rasteri/HIDman/hardware/ps2/ps2usb.kicad_pcb

## KiCad design hardware/ps2/ps2usb.kicad_pcb (2024-11-02)

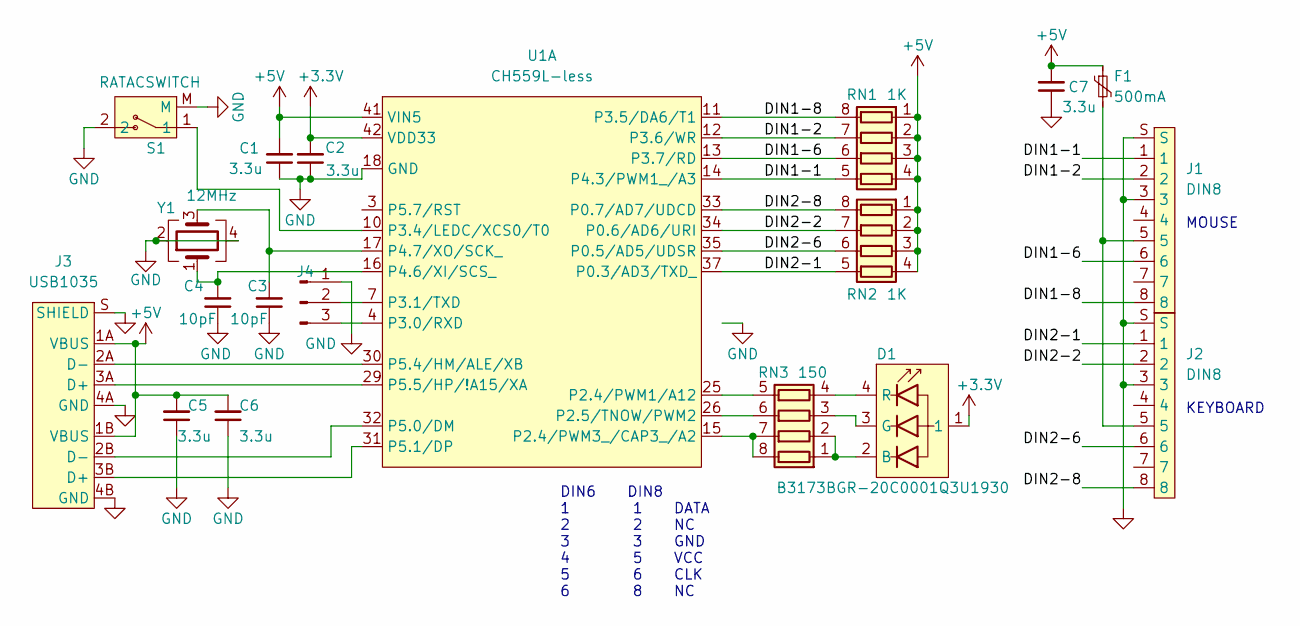
[picture p1: schematic ps2usb.kicad_sch]

Parts:
C1, C2, C5, C6, C7: 3.3u; C_0603_1608Metric
C3, C4: 10pF; C_0603_1608Metric
D1: B3173BGR-20C0001Q3U1930
F1: 500mA; Fuse_1206_3216Metric
J1, J2: DIN8
J3: USB1035
J4: Conn_01x03_Pin; PinHeader_1x03_P2.54mm_Vertical
RN1, RN2: 1K; R_Array_Convex_4x0603
RN3: 150; R_Array_Convex_4x0603
S1: RATACSWITCH; TS11
U1: CH559L-less; QFP-12x12_14x14_Pitch0.5mm
Y1: 12MHz; Crystal_SMD_3225-4Pin_3.2x2.5mm

Connections:
+3.3V: C2.2, D1.1, U1.42 (VDD33)
+5V: C1.2, C5.2, C6.2, C7.2, F1.1, J3.1A (VBUS), J3.1B (VBUS), RN1.1 (R1.1), RN1.2 (R2.1), RN1.3 (R3.1), RN1.4 (R4.1), RN2.1 (R1.1), RN2.2 (R2.1), RN2.3 (R3.1), RN2.4 (R4.1), U1.41 (VIN5)
/DIN1-1: J1.1, RN1.5 (R4.2), U1.14 (P4.3/PWM1_/A3)
/DIN1-2: J1.2, RN1.7 (R2.2), U1.12 (P3.6/WR)
/DIN1-6: J1.6, RN1.6 (R3.2), U1.13 (P3.7/RD)
/DIN1-8: J1.8, RN1.8 (R1.2), U1.11 (P3.5/DA6/T1)
/DIN2-1: J2.1, RN2.5 (R4.2), U1.37 (P0.3/AD3/TXD_)
/DIN2-2: J2.2, RN2.7 (R2.2), U1.34 (P0.6/AD6/URI)
/DIN2-6: J2.6, RN2.6 (R3.2), U1.35 (P0.5/AD5/UDSR)
/DIN2-8: J2.8, RN2.8 (R1.2), U1.33 (P0.7/AD7/UDCD)
GND: C1.1, C2.1, C3.1, C4.1, C5.1, C6.1, C7.1, J1.3, J1.S, J2.3, J2.S, J3.4A (GND), J3.4B (GND), J3.S (SHIELD), J4.1, S1.2, S1.M, U1.18 (GND), U1.20 (P4.0/A0/RXD1_), Y1.2, Y1.4
unnamed: D1.2 (B), RN3.1 (R1.1), RN3.2 (R2.1)
unnamed: D1.3 (G), RN3.3 (R3.1)
unnamed: D1.4 (R), RN3.4 (R4.1)
unnamed: F1.2, J1.5, J2.5
unnamed: J4.2, U1.7 (P3.1/TXD)
unnamed: J4.3, U1.4 (P3.0/RXD)
unnamed: RN3.7 (R2.2), RN3.8 (R1.2), U1.15 (P2.4/PWM3_/CAP3_/A2)
unnamed: RN3.6 (R3.2), U1.26 (P2.5/TNOW/PWM2)
unnamed: RN3.5 (R4.2), U1.25 (P2.4/PWM1/A12)
unnamed: S1.1, U1.10 (P3.4/LEDC/XCS0/T0)
unnamed: C4.2, U1.16 (P4.6/XI/SCS_), Y1.1
unnamed: C3.2, U1.17 (P4.7/XO/SCK_), Y1.3
unnamed: J3.2B (D-), U1.32 (P5.0/DM)
unnamed: J3.3B (D+), U1.31 (P5.1/DP)
unnamed: J3.2A (D-), U1.30 (P5.4/HM/ALE/XB)
unnamed: J3.3A (D+), U1.29 (P5.5/HP/!A15/XA)

Notes on the sheet:
DIN6 DIN8 1 1 DATA 2 2 NC 3 3 GND 4 5 VCC 5 6 CLK 6 8 NC
MOUSE
KEYBOARD

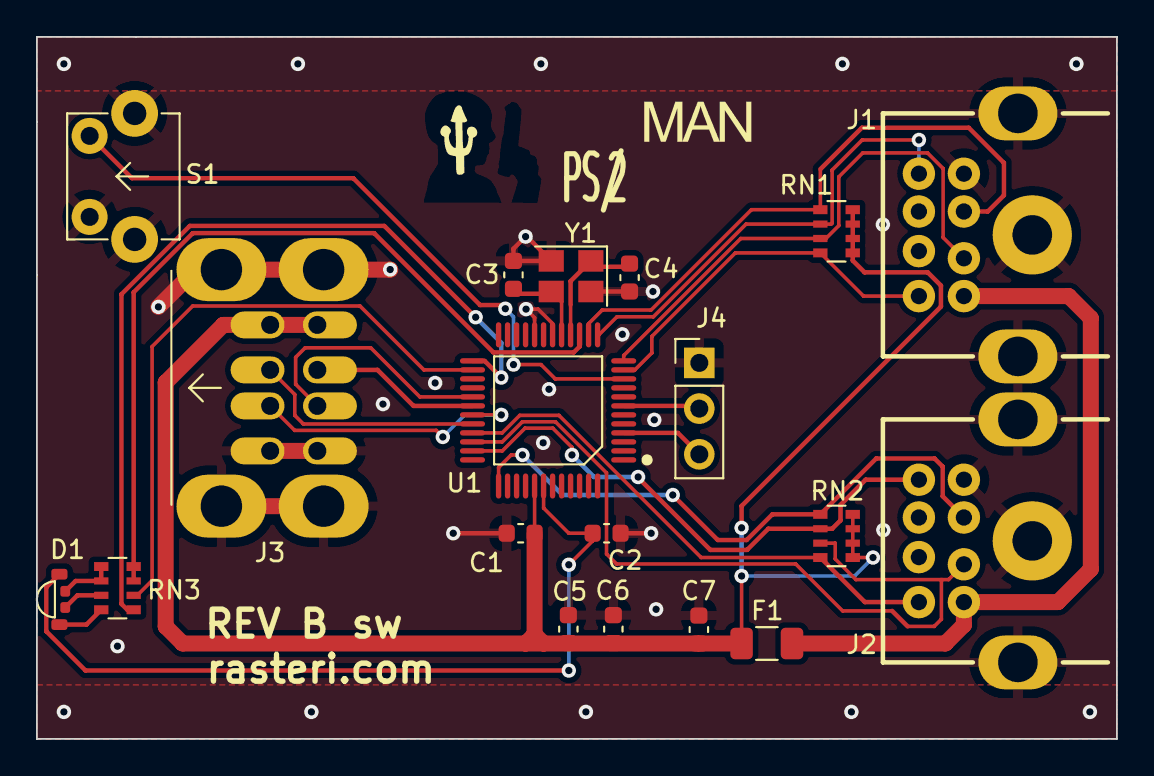
[picture p2: board hardware/ps2/ps2usb.kicad_pcb from above]

Board: 2 copper layers, 60.0 x 39.0 mm, 19 parts (0 on the bottom side), 27 nets.
