rasteri/HIDman/hardware/axp/ps2usb.kicad_pcb

## KiCad design hardware/axp/ps2usb.kicad_pcb (2024-06-11)

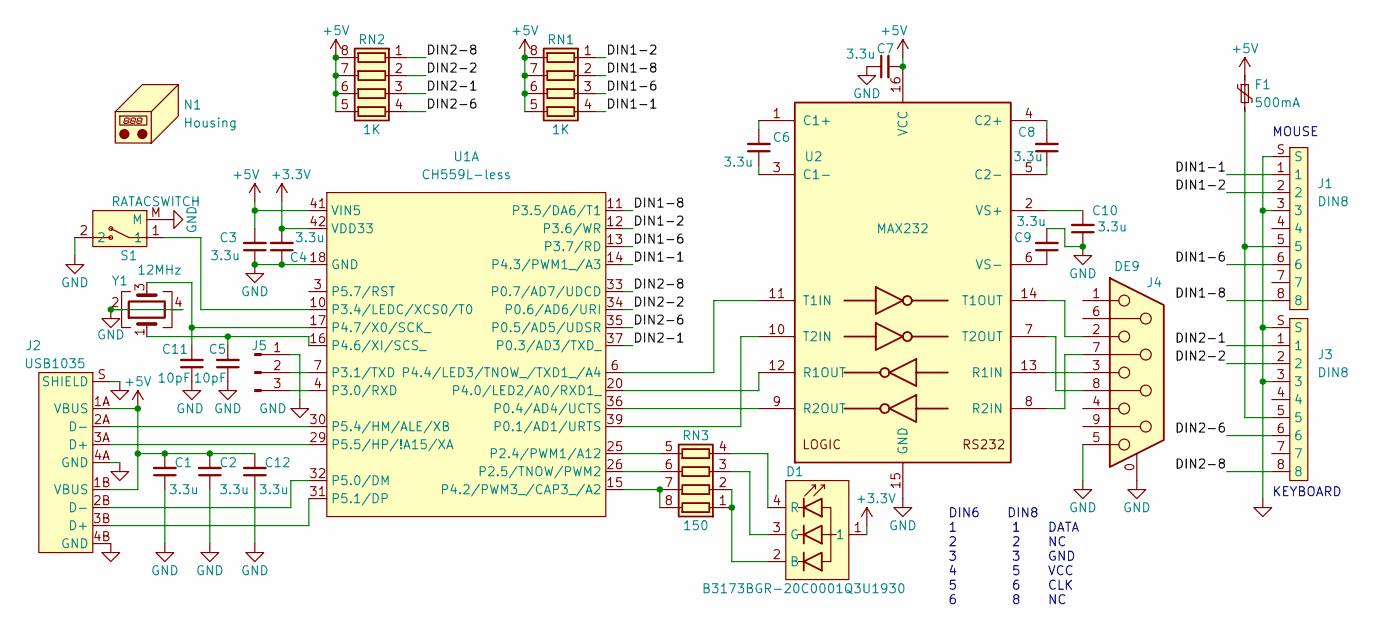
[picture p3: schematic ps2usb.kicad_sch]

Parts:
C1, C2, C3, C4, C6, C7, C8, C9, C10, C12: 3.3u; C_0603_1608Metric
C5, C11: 10pF; C_0603_1608Metric
D1: B3173BGR-20C0001Q3U1930
F1: 500mA; Fuse_1206_3216Metric
J1, J3: DIN8
J2: USB1035
J4: DE9; DSUB-9_Female_Horizontal_P2.77x2.84mm_EdgePinOffset7.70mm_H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
J5: Conn_01x03_Pin; PinHeader_1x03_P2.54mm_Vertical
N1: Housing; Enclosure
RN1, RN2: 1K; R_Array_Convex_4x0603
RN3: 150; R_Array_Convex_4x0603
S1: RATACSWITCH; TS11
U1: CH559L-less; QFP-12x12_14x14_Pitch0.5mm
U2: MAX232; SOIC-16_3.9x9.9mm_P1.27mm
Y1: 12MHz; Crystal_SMD_3225-4Pin_3.2x2.5mm

Connections:
+3.3V: C4.2, D1.1, U1.42 (VDD33)
+5V: C1.2, C2.2, C3.2, C7.2, C12.2, F1.1, J2.1A (VBUS), J2.1B (VBUS), RN1.5 (R4.2), RN1.6 (R3.2), RN1.7 (R2.2), RN1.8 (R1.2), RN2.5 (R4.2), RN2.6 (R3.2), RN2.7 (R2.2), RN2.8 (R1.2), U1.41 (VIN5), U2.16 (VCC)
/DIN1-1: J1.1, RN1.4 (R4.1), U1.14 (P4.3/PWM1_/A3)
/DIN1-2: J1.2, RN1.1 (R1.1), U1.12 (P3.6/WR)
/DIN1-6: J1.6, RN1.3 (R3.1), U1.13 (P3.7/RD)
/DIN1-8: J1.8, RN1.2 (R2.1), U1.11 (P3.5/DA6/T1)
/DIN2-1: J3.1, RN2.3 (R3.1), U1.37 (P0.3/AD3/TXD_)
/DIN2-2: J3.2, RN2.2 (R2.1), U1.34 (P0.6/AD6/URI)
/DIN2-6: J3.6, RN2.4 (R4.1), U1.35 (P0.5/AD5/UDSR)
/DIN2-8: J3.8, RN2.1 (R1.1), U1.33 (P0.7/AD7/UDCD)
GND: C1.1, C2.1, C3.1, C4.1, C5.1, C7.1, C9.2, C10.1, C11.1, C12.1, J1.3, J1.S, J2.4A (GND), J2.4B (GND), J2.S (SHIELD), J3.3, J3.S, J4.0 (PAD), J4.5, J5.1, S1.2, S1.M, U1.18 (GND), U2.15 (GND), Y1.2, Y1.4
unnamed: D1.2 (B), RN3.1 (R1.1), RN3.2 (R2.1)
unnamed: D1.3 (G), RN3.3 (R3.1)
unnamed: D1.4 (R), RN3.4 (R4.1)
unnamed: F1.2, J1.5, J3.5
unnamed: J5.2, U1.7 (P3.1/TXD)
unnamed: J5.3, U1.4 (P3.0/RXD)
unnamed: RN3.7 (R2.2), RN3.8 (R1.2), U1.15 (P4.2/PWM3_/CAP3_/A2)
unnamed: RN3.6 (R3.2), U1.26 (P2.5/TNOW/PWM2)
unnamed: RN3.5 (R4.2), U1.25 (P2.4/PWM1/A12)
unnamed: U1.39 (P0.1/AD1/URTS), U2.10 (T2IN)
unnamed: U1.36 (P0.4/AD4/UCTS), U2.9 (R2OUT)
unnamed: S1.1, U1.10 (P3.4/LEDC/XCS0/T0)
unnamed: U1.20 (P4.0/LED2/A0/RXD1_), U2.12 (R1OUT)
unnamed: U1.6 (P4.4/LED3/TNOW_/TXD1_/A4), U2.11 (T1IN)
unnamed: C5.2, U1.16 (P4.6/XI/SCS_), Y1.1
unnamed: C11.2, U1.17 (P4.7/X0/SCK_), Y1.3
unnamed: J2.2B (D-), U1.32 (P5.0/DM)
unnamed: J2.3B (D+), U1.31 (P5.1/DP)
unnamed: J2.2A (D-), U1.30 (P5.4/HM/ALE/XB)
unnamed: J2.3A (D+), U1.29 (P5.5/HP/!A15/XA)
unnamed: C6.2, U2.1 (C1+)
unnamed: C6.1, U2.3 (C1-)
unnamed: C8.2, U2.4 (C2+)
unnamed: C8.1, U2.5 (C2-)
unnamed: J4.3, U2.13 (R1IN)
unnamed: J4.7, U2.8 (R2IN)
unnamed: J4.2, U2.14 (T1OUT)
unnamed: J4.8, U2.7 (T2OUT)
unnamed: C10.2, U2.2 (VS+)
unnamed: C9.1, U2.6 (VS-)

Notes on the sheet:
DIN6 DIN8 1 1 DATA 2 2 NC 3 3 GND 4 5 VCC 5 6 CLK 6 8 NC
MOUSE
KEYBOARD

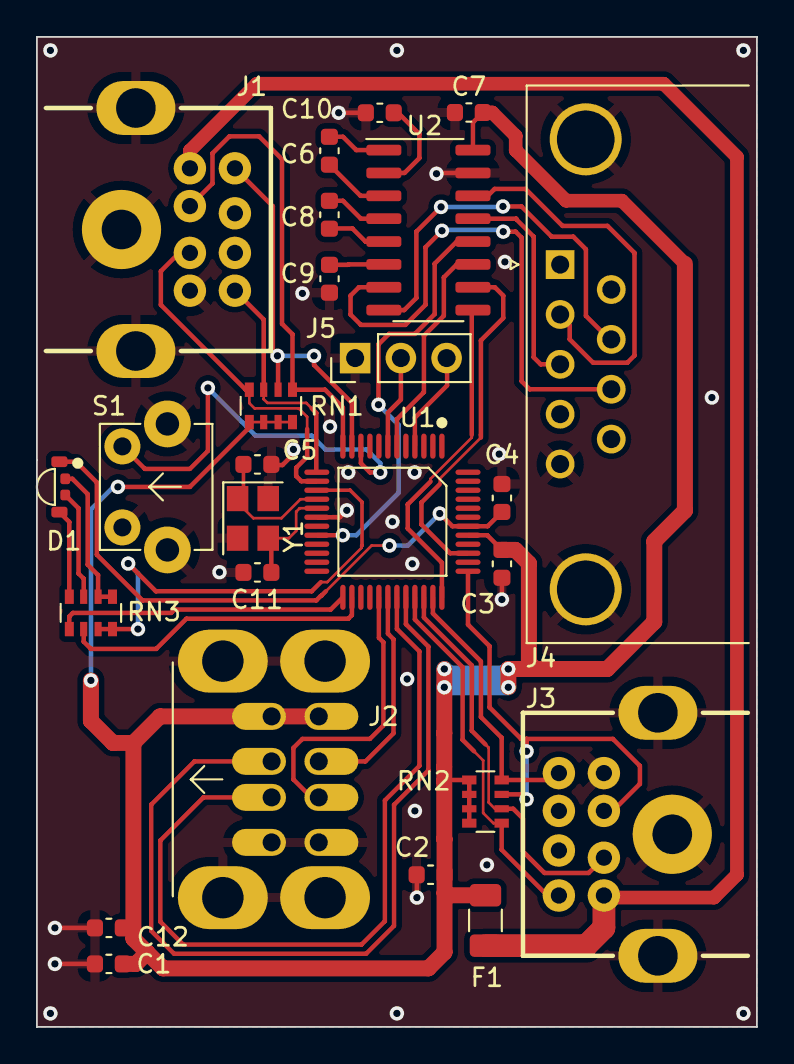
[picture p4: board hardware/axp/ps2usb.kicad_pcb from above]

Board: 2 copper layers, 40.0 x 55.0 mm, 26 parts (0 on the bottom side), 41 nets.
